ludodefgh/KicadDesignBlocks/TPS563201/docs/webench/small-footprint/WBBOMDesign6.csv

Part | Manufacturer | Part Number | Quantity | Price ($) | Footprint (mm²) | Description
Cbst | TDK | C0603X5R1E104K030BB | 1 | 0.01586 | 2.08 | Cap: 100 nF Total Derated Cap: 100 nF VDC: 25 V ESR: 70 mΩ Package: 0201
Cout | MuRata | GRM21BR61A226ME44L | 2 | 0.09 | 6.75 | Cap: 22 µF Total Derated Cap: 29 µF VDC: 10 V ESR: 3 mΩ Package: 0805
Rfbb | Yageo | RC0201FR-0710KL | 1 | 0.01 | 2.08 | Resistance: 10 kΩ Tolerance: 1.0% Power: 50 mW
L1 | Coilcraft | XAL4030-332MEB | 1 | 0.72 | 25 | L: 3.3 µH DCR: 26 mΩ IDC: 5.5 A
U1 | Texas Instruments | TPS563201DDCR | 1 | 0.137 | 10.47
Cin | Taiyo Yuden | MSAST219LB5106KTNA01 | 2 | 0.09498 | 6.75 | Cap: 10 µF Total Derated Cap: 10 µF VDC: 25 V ESR: 5.85 mΩ Package: 0805
Rfbt | Vishay-Dale | CRCW040233K2FKED | 1 | 0.01 | 3 | Resistance: 33.2 kΩ Tolerance: 1.0% Power: 63 mW
