ludodefgh/KicadDesignBlocks/TPS563201/docs/TPS563201-schematic.pdf

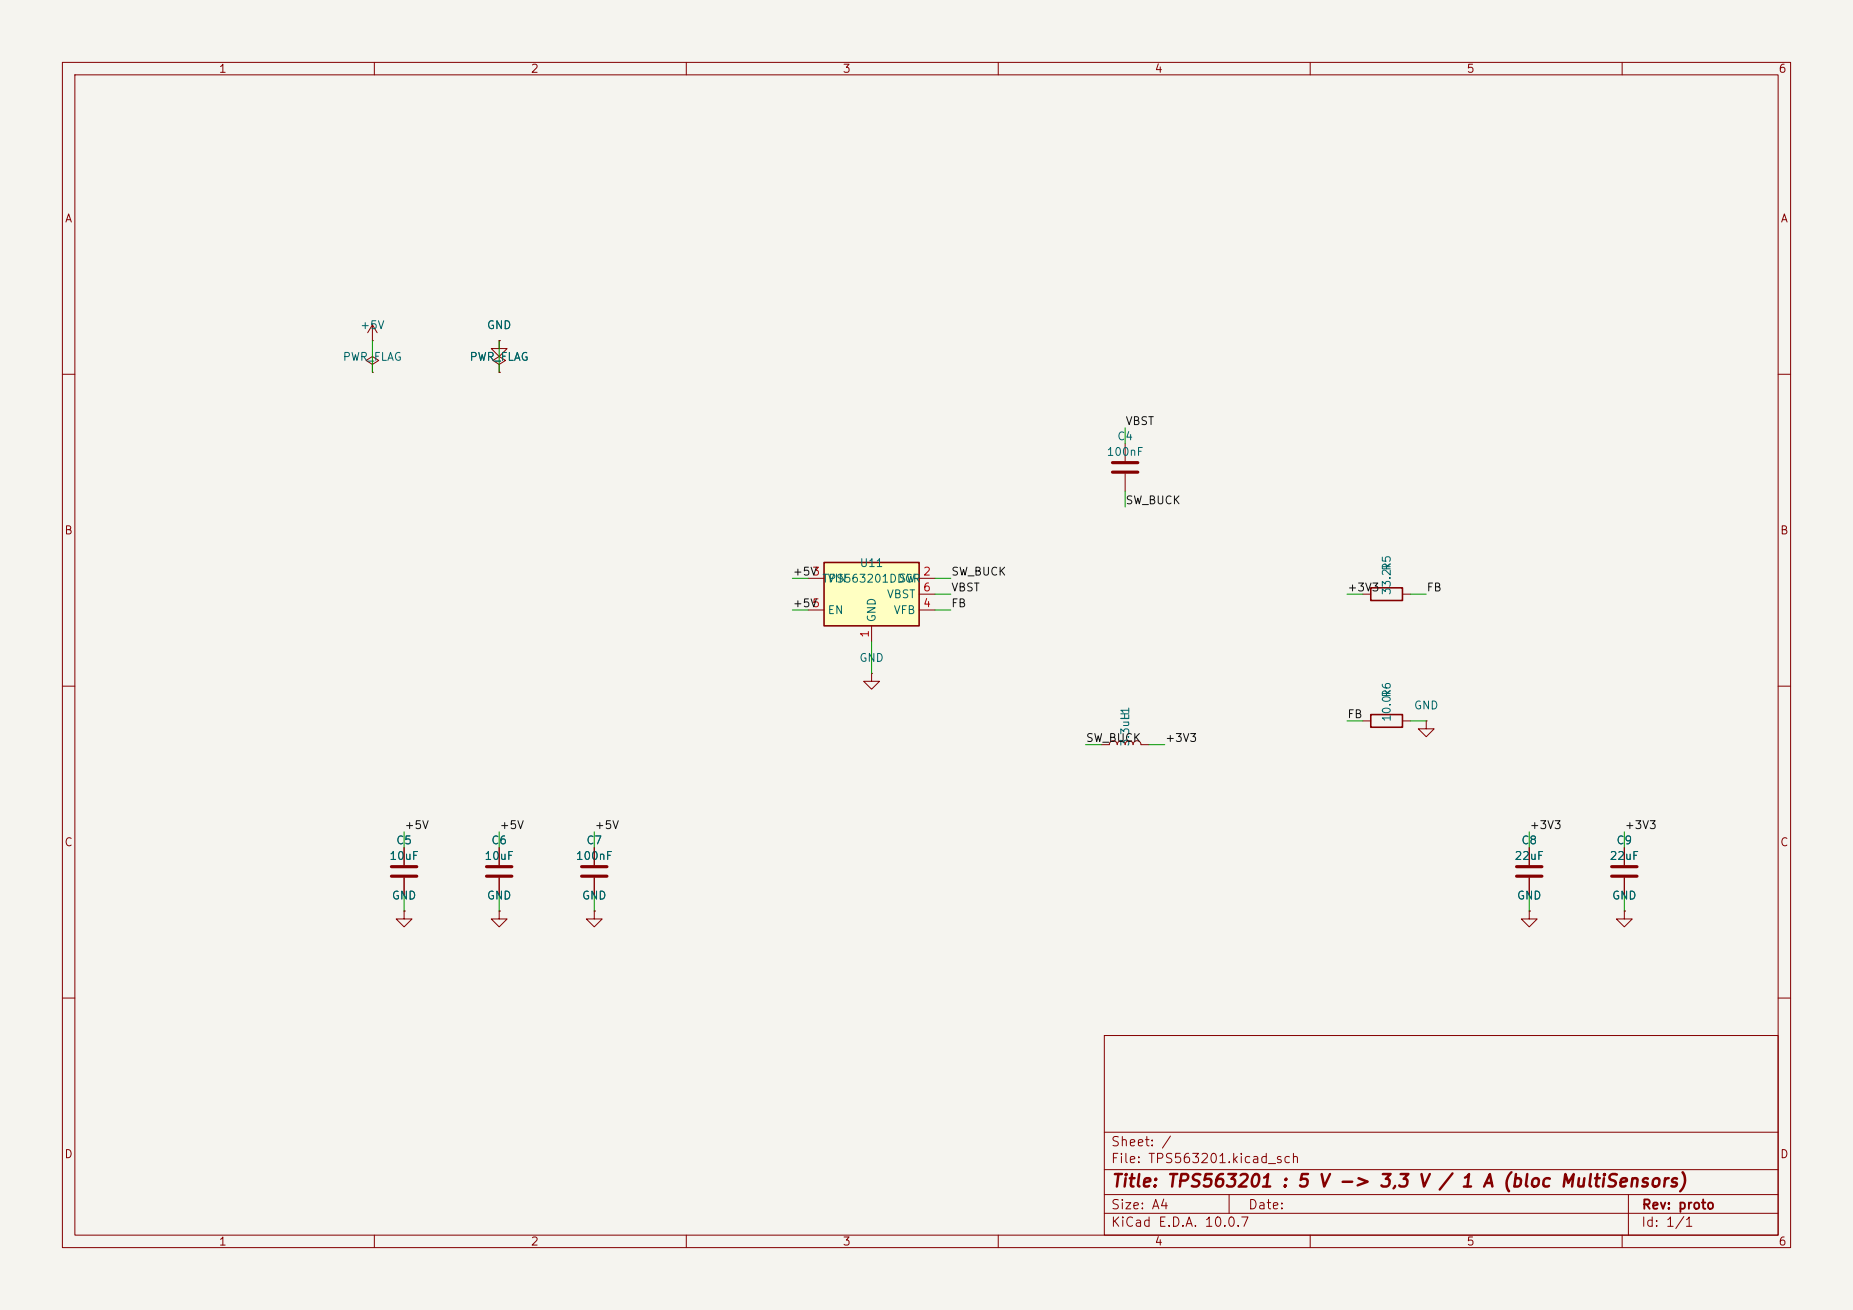
[picture p2: page 1]

Size: A4 | Rev: proto
KiCad E.D.A. 10.0.7 | Id: 1/1
