ludodefgh/KicadDesignBlocks/TPS5430Buck/TPS5430Buck.kicad_pcb

## KiCad design TPS5430Buck/TPS5430Buck.kicad_pcb (2026-10-23)

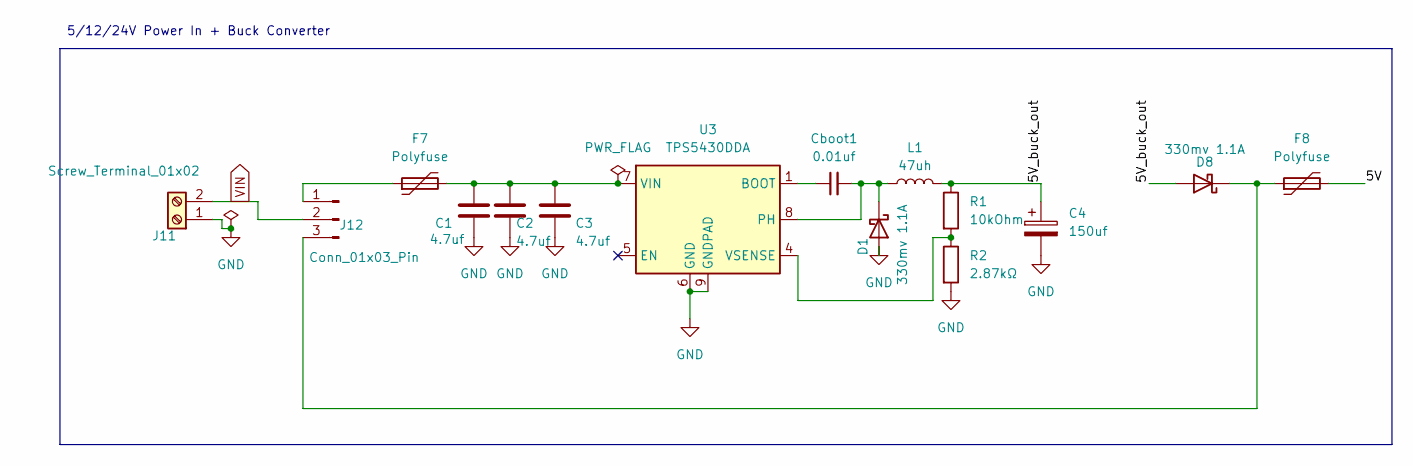
[picture p3: schematic TPS5430Buck.kicad_sch]

Parts:
C1, C2, C3: 4.7uf; C_1206_3216Metric; LCSC C29823
C4: 150uf; CP_EIA-7343-31_Kemet-D; LCSC C1953305
Cboot1: 0.01uf; R_0805_2012Metric; LCSC C1710
D1, D8: 330mv 1.1A; D_SMA; LCSC C8678
F7: Polyfuse; Fuse_1206_3216Metric; LCSC C7542958
F8: Polyfuse; Fuse_1206_3216Metric; LCSC C883127
J11: Screw_Terminal_01x02; TerminalBlock_Ningbo-Kagnex_HB9500M_1x02_P9.5mm; lcsc C601239
J12: Conn_01x03_Pin; PinHeader_1x03_P2.54mm_Vertical
L1: 47uh; L_7.3x7.3_H4.5; LCSC C168137
R1: 10kOhm; R_0201_0603Metric; LCSC C106225
R2: 2.87kΩ; R_0402_1005Metric; LCSC C334673
U3: TPS5430DDA; TI_SO-PowerPAD-8_ThermalVias; LCSC C9864

Connections:
/5V: F8.2
/5V_buck_out: C4.1, D8.2 (A), L1.2, R1.1
GND: C1.2, C2.2, C3.2, C4.2, D1.2 (A), J11.1, R2.2, U3.6 (GND), U3.9 (GNDPAD)
unnamed: Cboot1.2, D1.1 (K), L1.1, U3.8 (PH)
unnamed: D8.1 (K), F8.1, J12.3
unnamed: F7.1, J12.1
unnamed: Cboot1.1, U3.1 (BOOT)
unnamed: C1.1, C2.1, C3.1, F7.2, U3.7 (VIN)
unnamed: R1.2, R2.1, U3.4 (VSENSE)
VIN: J11.2, J12.2

Notes on the sheet:
5/12/24V Power In + Buck Converter

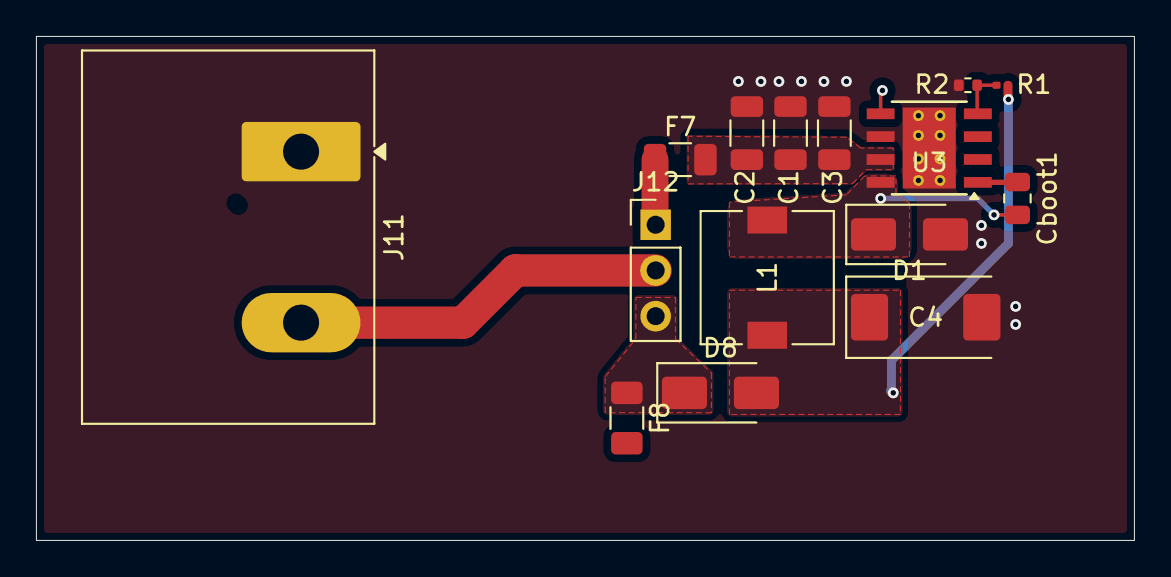
[picture p4: board TPS5430Buck.kicad_pcb from above]

Board: 2 copper layers, 61.0 x 28.0 mm, 15 parts (0 on the bottom side), 9 nets.
