ludodefgh/KicadDesignBlocks/TPS563201/TPS563201.kicad_pcb

## KiCad design TPS563201/TPS563201.kicad_pcb (2026-10-23)

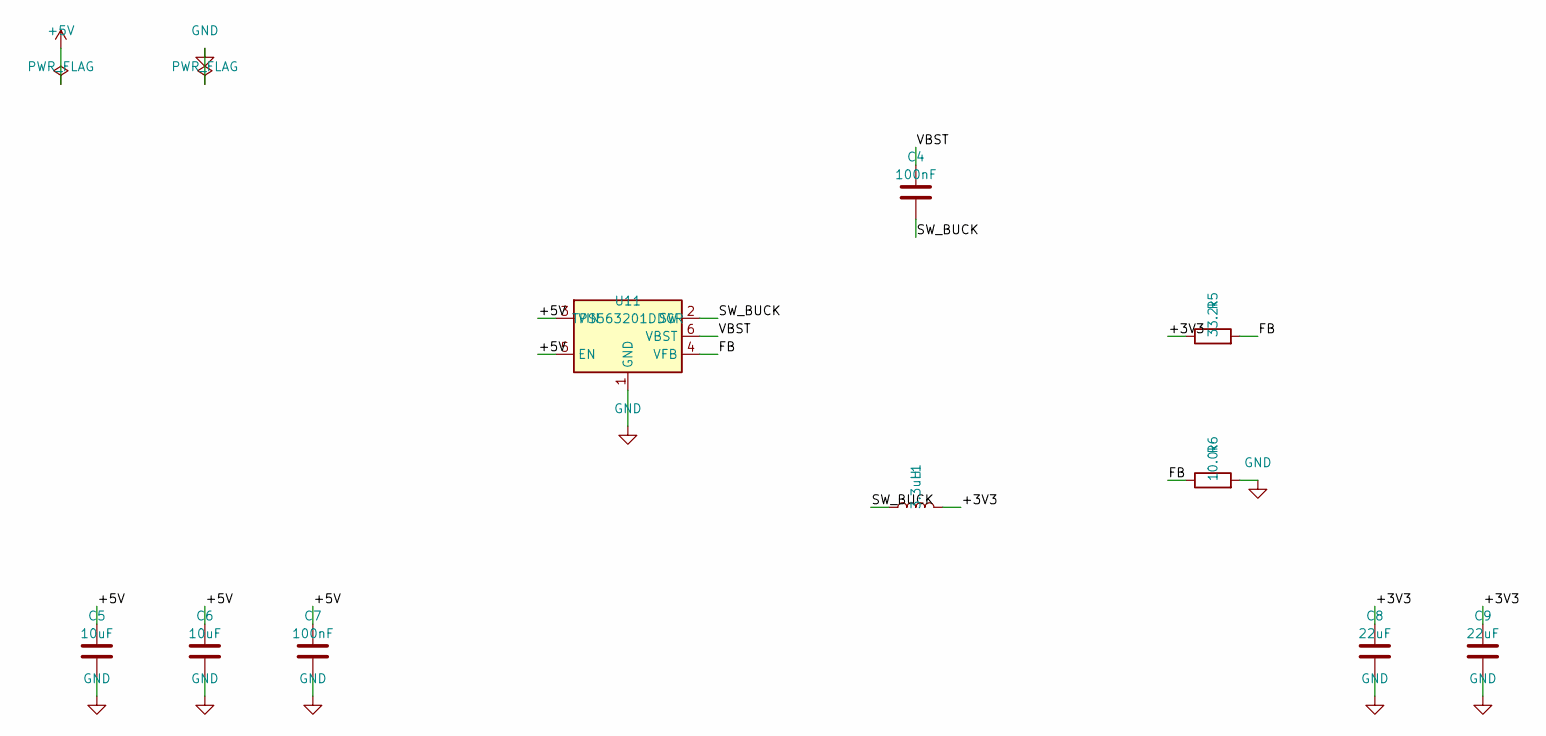
[picture p5: schematic TPS563201.kicad_sch, TPS563201 : 5 V -> 3,3 V / 1 A (bloc MultiSensors)]

Parts:
C4: 100nF; C_0402_1005Metric; MPN Samsung CL05B104KO5NNNC (100nF 16V X7R); LCSC C1525
C5, C6: 10uF; C_0805_2012Metric; MPN Samsung CL21A106KAYNNNE (10uF 25V X5R); LCSC C15850
C7: 100nF; C_0805_2012Metric
C8, C9: 22uF; C_0805_2012Metric; MPN Samsung CL21A226MAQNNNE (22uF 25V X5R); LCSC C45783
L1: 3.3uH; L_Sunlord_SWPA4030S; MPN Sunlord SWPA4030S3R3MT; LCSC C15269
R5: 33.2k; R_0402_1005Metric
R6: 10.0k; R_0402_1005Metric
U11: TPS563201DDCR; SOT-23-6

Connections:
+5V: C5.1, C6.1, C7.1, U11.3 (VIN), U11.5 (EN)
/+3V3: C8.1, C9.1, L1.2, R5.1
/FB: R5.2, R6.1, U11.4 (VFB)
/SW_BUCK: C4.2, L1.1, U11.2 (SW)
/VBST: C4.1, U11.6 (VBST)
GND: C5.2, C6.2, C7.2, C8.2, C9.2, R6.2, U11.1 (GND)

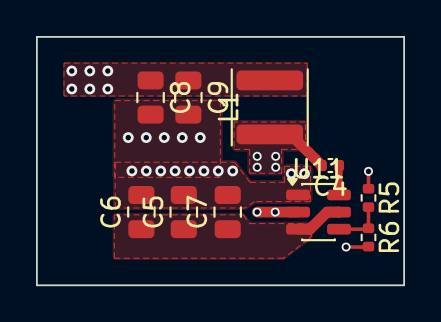
[picture p6: board TPS563201.kicad_pcb from above]

Board: 4 copper layers, 20.4 x 13.8 mm, 10 parts (0 on the bottom side), 6 nets.
