ludodefgh/KicadDesignBlocks/(commit log)

2026-04-03 Initial commit: TPS5430 buck converter KiCad project
    [TPS5430Buck.kicad_pcb, TPS5430Buck.kicad_sch]
2026-10-23 Init KicadDesignBlocks
2026-10-23 Add TPS563201 block (5 V -> 3.3 V) exported from MultiSensors, repo README
    Self-contained KiCad 10 project: schematic, 4-layer layout (the hand-drawn U11
    group from MultiSensors, inner planes cut to the block outline), project-local
    symbol library, schematic PDF, layout SVG, 3D render and the TI WEBENCH exports.
    ERC: 1 warning; DRC: 0 errors, 0 unconnected, 0 parity issues.
    [TPS563201.kicad_pcb, TPS563201.kicad_sch, WBBOMDesign6.csv]
2026-10-23 TPS5430Buck: fuse re-annotation (F10->F8, F9->F7) and project settings rewritten by newer KiCad
    Uncommitted state carried over from the former TPS5430Buck repo.
    [TPS5430Buck.kicad_pcb, TPS5430Buck.kicad_sch]
2026-10-24 TPS563201 README: bootstrap SW trace is ~1.3 mm from L1's pad, not 5 mm over U11
    The earlier figure described the layout before C4 was moved next to L1.
